OE5XRX/HW-Enclosure/rack-19/README.md

# 19-inch rack enclosure

Planned. Not started yet.
