OE5XRX/HW-Enclosure/pcb/SOURCES.md

# PCB STEP sources

| module | repo | commit | file | kicad-cli version | note |
|---|---|---|---|---|---|
| BusBoard | OE5XRX/HW-Module-BusBoard | d8b12e2971c004760d6b3833b60bcc210132e58e | BusBoard.kicad_pcb | 10.0.5 | models remapped to KiCad 10; --include-pads --include-silkscreen --include-soldermask |
| PowerBoard | OE5XRX/HW-Module-PowerBoard | 84e5044811136f9b861628f93d8f471a453b0347 | PowerBoard.kicad_pcb | 10.0.5 | models remapped to KiCad 10; --include-pads --include-silkscreen --include-soldermask |
| CM4Carrier | OE5XRX/HW-Module-CM4Carrier | 452df896838805c448f313430fcc469cdcd9ab93 | CM4Carrier.kicad_pcb | 10.0.5 | models remapped to KiCad 10; --include-pads --include-silkscreen --include-soldermask |
| FMTransceiver | OE5XRX/HW-Module-FMTransceiver | 30d8ed2c2af21de2f1deb8761875d8444cd480c9 | FMTransceiver.kicad_pcb | 10.0.5 | models remapped to KiCad 10; --include-pads --include-silkscreen --include-soldermask |
| DeviceTester | OE5XRX/HW-Module-DeviceTester | fb55e541ce178de05d0d9ece02d80e6084f04e36 | DeviceTester.kicad_pcb | 10.0.5 | models remapped to KiCad 10; --include-pads --include-silkscreen --include-soldermask |
| DeviceTester-slot | OE5XRX/HW-Module-DeviceTester | fb55e541ce178de05d0d9ece02d80e6084f04e36 | DeviceTester.kicad_pcb | 10.0.5 | variant Slot, --no-dnp; models remapped to KiCad 10; --include-pads --include-silkscreen --include-soldermask |
