OE5XRX/HW-Enclosure/reference/logo_2025.dxf

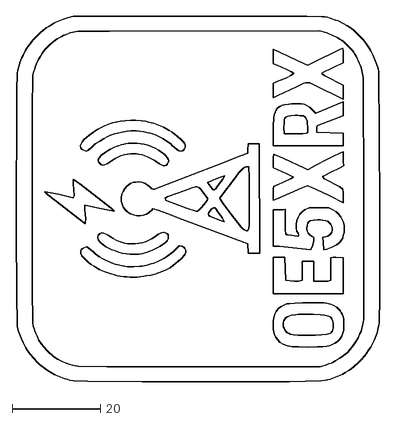
[picture p10: CAD file, 2026-11-08]
reference/logo_2025.dxf
82.4 x 82.9
