OE5XRX/HW-Enclosure/(list of files, cad)

Other CAD files:
desktop/parts/schraube-m3x6.step
pcb/FMTransceiver.step
desktop/parts/einschmelzmutter-m3.step
pcb/DeviceTester-slot.step
desktop/parts/schraube-m3x8.step
pcb/DeviceTester.step
desktop/parts/deckplatte.step
pcb/BusBoard.step
desktop/parts/grundgestell-gespiegelt.step
pcb/CM4Carrier.step
desktop/parts/grundgestell.step
pcb/PowerBoard.step
desktop/parts/leiste.step
