OE5XRX/HW-Enclosure/(commit log)

2026-11-08 docs: HW-Enclosure design and implementation plan
2026-11-08 chore: scaffold HW-Enclosure with reconstructed desktop parts
    Add repo skeleton, SolidCraft MCP client and part checker; move the
    reconstructed leiste, deckplatte and grundgestell (mirrored) into desktop/parts.
    [deckplatte.step, grundgestell-gespiegelt.step, leiste.step, logo_2025.dxf]
2026-11-08 feat(pcb): export module STEPs from origin/main
    [BusBoard.step, CM4Carrier.step, DeviceTester-slot.step, DeviceTester.step, FMTransceiver.step, PowerBoard.step]
2026-11-08 feat(desktop): add normal frame as mirror of reconstructed frame
    [grundgestell-gespiegelt.step, grundgestell.step]
2026-11-08 feat(desktop): cover plate with current OE5XRX branding logo
    Replace the old 2025 logo (traced from G-code) on the cover plate with
    logo/oe5xrx-full.svg from OE5XRX/branding (eec51928d8f8), 80 mm wide,
    centred, raised logo_h = 0.6 mm.
    tools/outline_svg.py converts the SVG to filled outlines (strokes with
    round caps/joins become areas, overlaps united into simple loops), since
    sketch.insert_svg imports only stroke centrelines. Outlined area
    855.83 mm^2; check_parts expects 38513.53 + 855.83 * 0.6 mm^3.
    [deckplatte.step]
2026-11-08 fix(tools): absolute volume tolerance in part checker
    tol_vol was read as a percent (+-195 mm^3 on the cover plate), too coarse
    to catch a missing logo element or hole. It is now an absolute tolerance
    in mm^3 (default 0.5); all parts pass on the default. Also ignore
    SolidCraft's *.sc.bak save backups.
2026-11-08 docs(reference): derive station assembly placement
2026-11-08 feat(desktop): station assembly with modules
2026-11-08 docs(reference): station fit check
    Read-only fit check of desktop/station.sc via inspect.clearance and
    body_topology: grooves pass, BusBoard holes pass, connectors mate with a
    0.1 mm axial overlap of the vendor models (6 collisions, 4.129 mm3 each).
    Adds tools/fit_check.py, reference/fit-check.{md,json} and screenshots.
2026-11-08 fix(reference): fit-check exit contract and board-thickness artefact
    Exit 1 unless all three checks pass; groove clearance from the nominal
    1.6012 board (body thickness 1.516 is an export artefact); reword the
    connector overlap and the clearance pair counts.
2026-11-08 Fix final-review findings: Deckplatte names, BusBoard hole labels, tool exit codes, SOURCES merge, README
2026-11-09 pcb: export full 3D models and board detail
    The boards reference ${KICAD8/9_3DMODEL_DIR}/*.wrl models. KiCad 10 ships
    only .step files, and --subst-models substitutes only when the .wrl
    exists, so every passive and IC silently dropped out of the STEPs.
    Export from a git-archive copy with the paths remapped to
    KICAD10_3DMODEL_DIR/.step (VSSOP-10 3x3 -> MSOP-10 3x3), fail on any
    missing model, and add pads, silkscreen and solder mask.
    [BusBoard.step, CM4Carrier.step, DeviceTester-slot.step, DeviceTester.step, FMTransceiver.step, PowerBoard.step]
2026-11-09 deckplatte: turn logo so the lettering faces the BusBoard
    Rotate the logo sketch plane by 90 deg. Both side plates now show the
    lettering next to the bus, using the same part.
2026-11-09 station: drop back strips, re-import detailed PCB STEPs
2026-11-09 fasteners: M3 screws and heat-set inserts as parts, 48 occurrences in station
    [einschmelzmutter-m3.step, schraube-m3x6.step, schraube-m3x8.step]
2026-11-09 docs, fit check and images for the rebuilt station
    Back strips removed, detailed PCB STEPs, M3 fasteners; station.sc saved compact
    without cache (10 MB). Fit check rerun (4725 bodies), fastener check D added.
